Chidanand26/Service_Robot/front.png

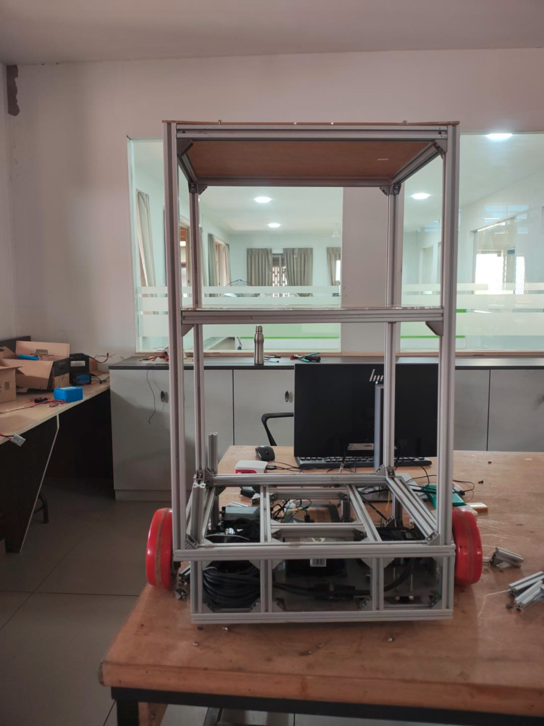
front.png
