Chidanand26/Service_Robot/top.png

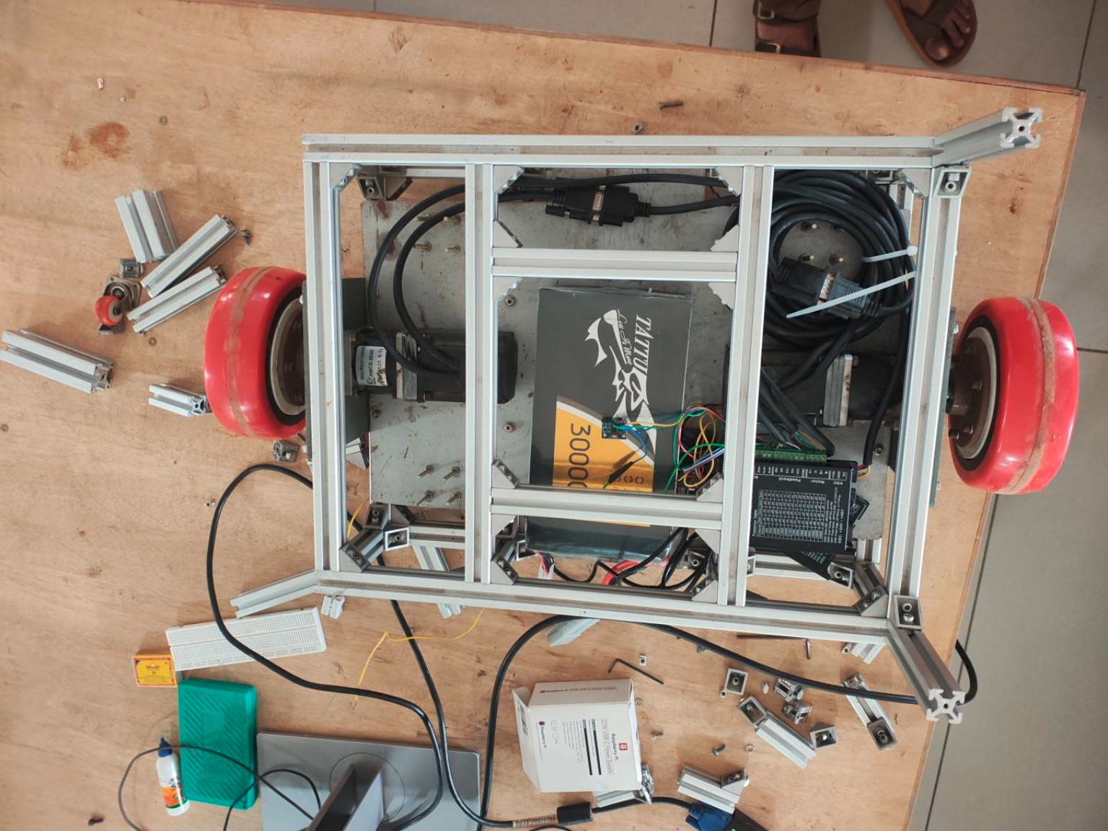
top.png
