Chidanand26/Service_Robot/error.png

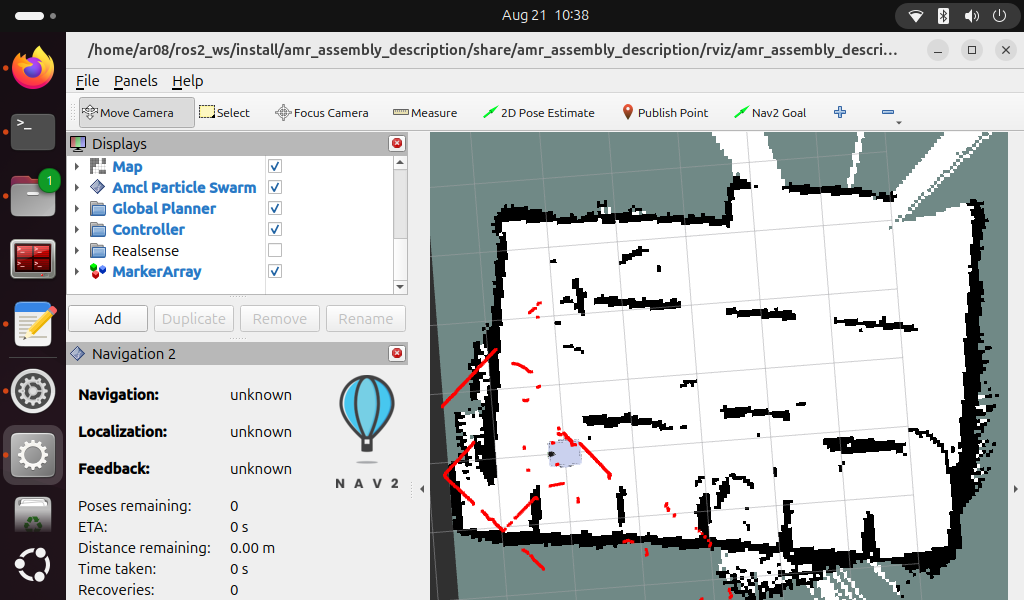
error.png
