Chidanand26/Service_Robot/isometric.png

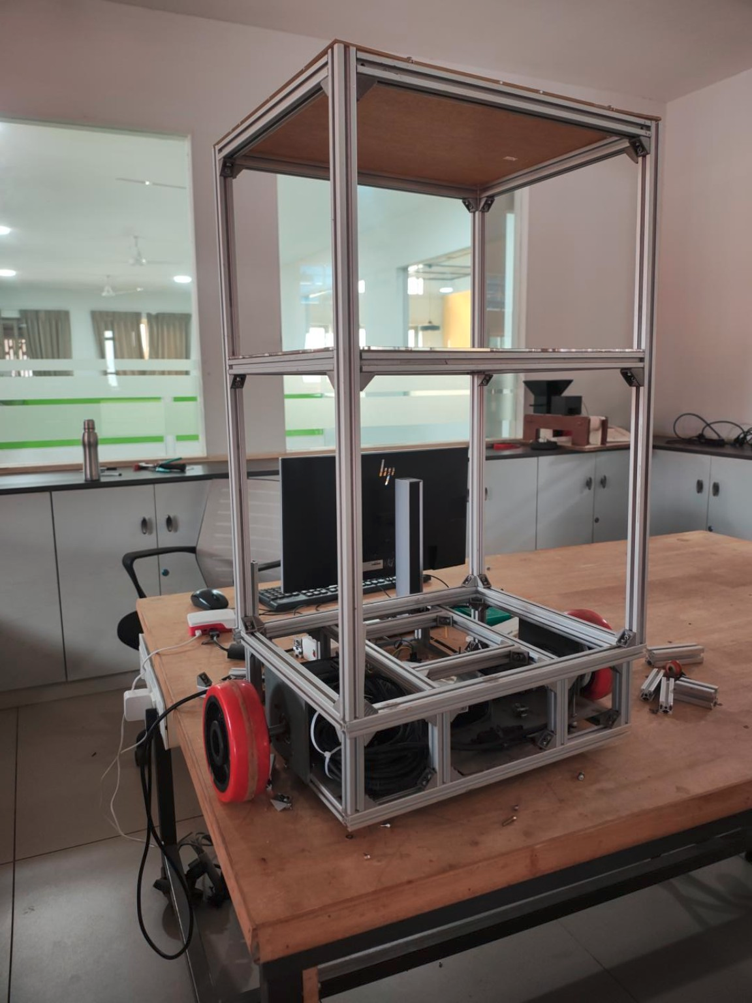
isometric.png
