Chidanand26/Service_Robot/src/amr_assembly_description/meshes/C_wheel_2_WS_1.stl

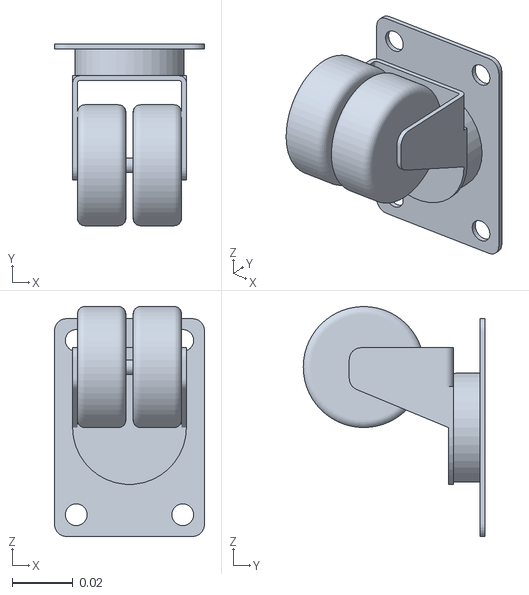
[picture p7: CAD file, 2026-08-15]
src/amr_assembly_description/meshes/C_wheel_2_WS_1.stl
0.0496 x 0.06 x 0.076
