Chidanand26/Service_Robot/src/amr_assembly_description/meshes/imu_1.stl

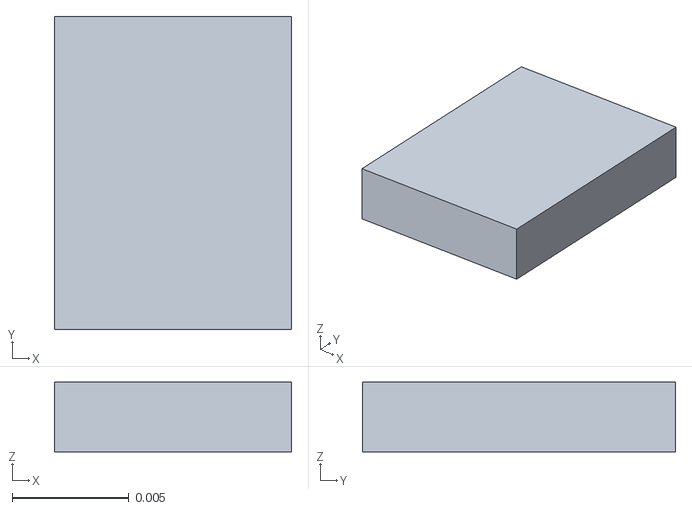
[picture p8: CAD file, 2026-08-15]
src/amr_assembly_description/meshes/imu_1.stl
0.0102 x 0.0134 x 0.003
