Chidanand26/Service_Robot/src/amr_assembly_description/meshes/wheel_1_2.stl

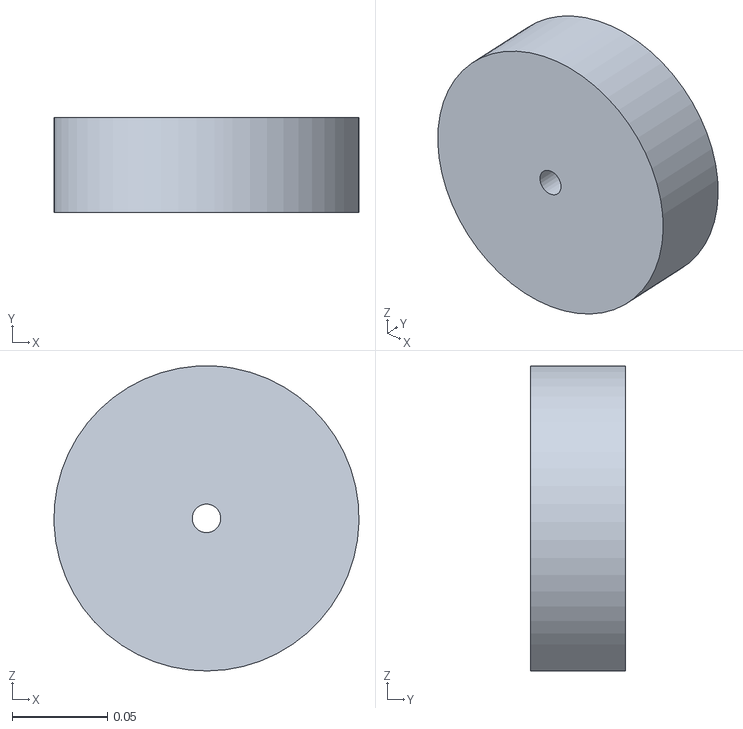
[picture p9: CAD file, 2026-08-15]
src/amr_assembly_description/meshes/wheel_1_2.stl
0.16 x 0.05 x 0.16
