Chidanand26/Service_Robot/src/amr_assembly_description/meshes/Chassis_1.stl

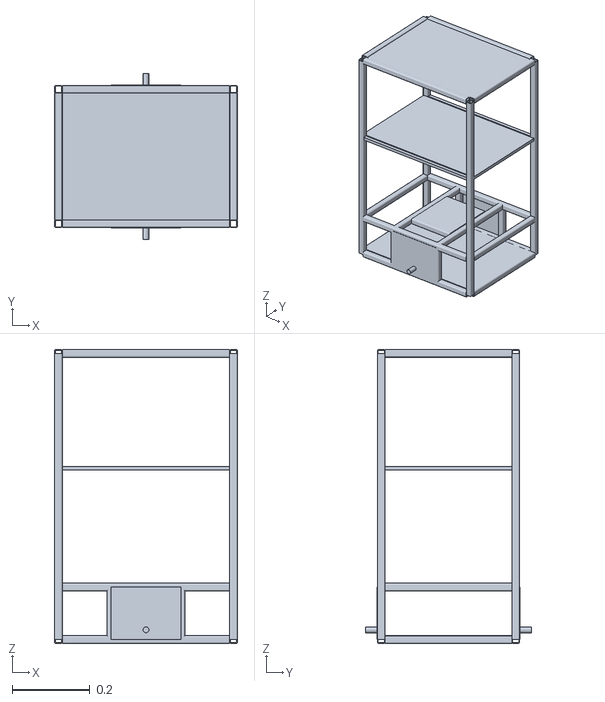
[picture p10: CAD file, 2026-08-15]
src/amr_assembly_description/meshes/Chassis_1.stl
0.47 x 0.427 x 0.755
