Chidanand26/Service_Robot/(list of files, cad)

Other CAD files:
src/amr_assembly_description/meshes/wheel_1.stl
