Chidanand26/Service_Robot/(commit log)

2026-08-15 Initial commit: AMR Service Robot full ROS 2 Jazzy mapping, navigation, ESP32 firmware, and udev rules
    [C_wheel_2_WS_1.stl, Chassis_1.stl, amr_assembly_description.urdf, base_link_collision.stl, imu_1.stl, lidar_collision.stl, robot_data.yaml, ros2_controllers.yaml]
2026-08-15 Smooth motion profile: 50Hz timer-driven S-curve jerk-limited filter, direct velocity mode, gentle teleop scaling
2026-08-21 Add comprehensive PROJECT_SUMMARY.md detailing architecture, wiring, and solved challenges
2026-08-21 Upgrade ESP32 firmware to 20kHz Hardware Timer DDS Phase-Accumulator engine for jitter-free stepping
    [esp32_serial_only.ino]
2026-08-21 Add universal ESP32 Core 2.x/3.x DDS timer support and automatic port detection in launch files
2026-08-21 Fix CS-D508 optocoupler step pulse width, parse with strtof, and default enable_camera to false for clean mapping
    [esp32_serial_only.ino]
2026-08-21 Update physical robot parameters (wheel radius 70mm, track width 370mm), restore silky smooth S-curve, and verify SLAM mapping
    [amr_assembly_description.urdf]
2026-08-21 Fix SLAM lifecycle race condition, fix ESP32 flash corruption, clean SHM
2026-08-21 Auto-detect ESP32 on USB0 and RPLiDAR on USB1 with clean port resolution
2026-08-21 Fix slam_lifecycle_auto_starter state query and stop polling when active
    [slam_lifecycle_auto_starter.py]
2026-08-21 Added Autonomous Navogation
    [pyvenv.cfg]
2026-08-22 Refactor robot URDF, wheel joints, TF frames, and Nav2 footprint to canonical ROS orientation
    [amr_assembly_description.urdf]
2026-08-22 Fix display.launch.py fallback when joint_state_publisher_gui is not installed and add display.rviz
2026-08-22 Update chassis orientation (90 deg) and drive wheels to Y=±0.235m (W=0.470m) matching real AMR hardware
    [amr_assembly_description.urdf]
2026-08-22 Center chassis mesh (xyz=0.1725 0.225 0) and align wheel mesh origins in URDF
    [amr_assembly_description.urdf]
2026-08-22 Align LiDAR (X=0.180m, Z=0.760m) and Camera (X=0.215m, Z=0.157m) cleanly onto the front chassis beams
    [amr_assembly_description.urdf]
2026-08-22 Fix missing time and os imports in esp32_driver_node.py
    [esp32_driver_node.py]
2026-08-22 Fix esp32_driver_node initialization order and implement staggered TimerAction launch
    [esp32_driver_node.py]
